sebasusnik/luz-galeria/exports/luz-galeria.netlist.txt

COMPONENTS:
 - J_IN: 
 - D1: D1, source_component
 - C_BULK: 220uF capacitor
 - J_OUT: 
 - ENC: 
 - RPU_A: 10kΩ resistor
 - RPU_B: 10kΩ resistor
 - RPU_SW: 10kΩ resistor
 - C_A: 10nF capacitor
 - C_B: 10nF capacitor
 - C_SW: 10nF capacitor
 - ESP: 
 - C_ESP: 100nF capacitor
 - J_RDR: 
 - C_RDR: 100nF capacitor
 - U_BUCK: 
 - R_LED: 1kΩ resistor
 - LED_PWR: LED_PWR, source_component
 - Q_WW: 
 - RG_WW: 100Ω resistor
 - RPD_WW: 10kΩ resistor
 - Q_CW: 
 - RG_CW: 100Ω resistor
 - RPD_CW: 10kΩ resistor

NET: D1_pos
  - J_IN V24
  - D1 pin1 (+)

NET: V3V3
  - ESP V3V3
  - RPU_SW pin2
  - RPU_B pin2
  - RPU_A pin2

NET: ENC_A
  - ESP IO4
  - C_A pin1 (+)
  - RPU_A pin1
  - ENC pin2

NET: ENC_B
  - ESP IO5
  - C_B pin1 (+)
  - RPU_B pin1
  - ENC pin3

NET: ENC_SW
  - ESP IO6
  - C_SW pin1 (+)
  - RPU_SW pin1
  - ENC pin4

NET: RDR_TX
  - J_RDR TX
  - ESP IO20

NET: RDR_RX
  - J_RDR RX
  - ESP IO21

NET: RDR_OUT
  - J_RDR OUT
  - ESP IO7

NET: V24
  - U_BUCK INp
  - J_OUT Vplus
  - C_BULK pin1 (+)
  - D1 pin2 (-)

NET: V5
  - R_LED pin1
  - U_BUCK OUTp
  - C_RDR pin1 (+)
  - J_RDR VCC
  - C_ESP pin1 (+)
  - ESP 5V

NET: LED_PWR_pos
  - R_LED pin2
  - LED_PWR pin1 (+)

NET: PWM_WW
  - RG_WW pin1
  - ESP IO10

NET: Q_WW_G
  - RPD_WW pin1
  - RG_WW pin2
  - Q_WW pin1

NET: WW
  - Q_WW pin2
  - J_OUT WW

NET: PWM_CW
  - RG_CW pin1
  - ESP IO3

NET: Q_CW_G
  - RPD_CW pin1
  - RG_CW pin2
  - Q_CW pin1

NET: GND
  - Q_CW pin3
  - RPD_CW pin2
  - Q_WW pin3
  - RPD_WW pin2
  - LED_PWR pin2 (-)
  - U_BUCK OUTn
  - U_BUCK INn
  - C_RDR pin2 (-)
  - J_RDR GND
  - C_ESP pin2 (-)
  - ESP GND
  - C_SW pin2 (-)
  - C_B pin2 (-)
  - C_A pin2 (-)
  - ENC pin7
  - ENC pin6
  - ENC pin5
  - ENC pin1
  - C_BULK pin2 (-)
  - J_IN GND

NET: CW
  - Q_CW pin2
  - J_OUT CW

COMPONENT_PINS:
J_IN
- pin1(V24): NETS(D1_pos)
- pin2(GND): NETS(GND)

D1
- pin1(pos, anode, left): NETS(D1_pos)
- pin2(neg, cathode, right): NETS(V24)

C_BULK (220uF undefined)
- pin1(pos): NETS(V24)
- pin2(neg): NETS(GND)

J_OUT
- pin1(Vplus): NETS(V24)
- pin2(WW): NETS(WW)
- pin3(CW): NETS(CW)

ENC
- pin1(C): NETS(GND)
- pin2(A): NETS(ENC_A)
- pin3(B): NETS(ENC_B)
- pin4(S1): NETS(ENC_SW)
- pin5(S2): NETS(GND)
- pin6(MP1): NETS(GND)
- pin7(MP2): NETS(GND)

RPU_A (10kΩ undefined)
- pin1(anode, pos, left): NETS(ENC_A)
- pin2(cathode, neg, right): NETS(V3V3)

RPU_B (10kΩ undefined)
- pin1(anode, pos, left): NETS(ENC_B)
- pin2(cathode, neg, right): NETS(V3V3)

RPU_SW (10kΩ undefined)
- pin1(anode, pos, left): NETS(ENC_SW)
- pin2(cathode, neg, right): NETS(V3V3)

C_A (10nF undefined)
- pin1(pos, left, anode): NETS(ENC_A)
- pin2(neg, right, cathode): NETS(GND)

C_B (10nF undefined)
- pin1(pos, left, anode): NETS(ENC_B)
- pin2(neg, right, cathode): NETS(GND)

C_SW (10nF undefined)
- pin1(pos, left, anode): NETS(ENC_SW)
- pin2(neg, right, cathode): NETS(GND)

ESP
- pin1(5V): NETS(V5)
- pin2(GND): NETS(GND)
- pin3(V3V3): NETS(V3V3)
- pin4(IO4): NETS(ENC_A)
- pin5(IO3): NETS(PWM_CW)
- pin6(IO2): NOT_CONNECTED
- pin7(IO1): NOT_CONNECTED
- pin8(IO0): NOT_CONNECTED
- pin9(IO5): NETS(ENC_B)
- pin10(IO6): NETS(ENC_SW)
- pin11(IO7): NETS(RDR_OUT)
- pin12(IO8): NOT_CONNECTED
- pin13(IO9): NOT_CONNECTED
- pin14(IO10): NETS(PWM_WW)
- pin15(IO20): NETS(RDR_TX)
- pin16(IO21): NETS(RDR_RX)

C_ESP (100nF undefined)
- pin1(pos, left, anode): NETS(V5)
- pin2(neg, right, cathode): NETS(GND)

J_RDR
- pin1(VCC): NETS(V5)
- pin2(GND): NETS(GND)
- pin3(TX): NETS(RDR_TX)
- pin4(RX): NETS(RDR_RX)
- pin5(OUT): NETS(RDR_OUT)

C_RDR (100nF undefined)
- pin1(pos, left, anode): NETS(V5)
- pin2(neg, right, cathode): NETS(GND)

U_BUCK
- pin1(INp): NETS(V24)
- pin2(INn): NETS(GND)
- pin3(OUTp): NETS(V5)
- pin4(OUTn): NETS(GND)

R_LED (1kΩ undefined)
- pin1(anode, pos, left): NETS(V5)
- pin2(cathode, neg, right): NETS(LED_PWR_pos)

LED_PWR
- pin1(anode, pos, left): NETS(LED_PWR_pos)
- pin2(cathode, neg, right): NETS(GND)

Q_WW
- pin1(G): NETS(Q_WW_G)
- pin2(D): NETS(WW)
- pin3(S): NETS(GND)

RG_WW (100Ω undefined)
- pin1(anode, pos, left): NETS(PWM_WW)
- pin2(cathode, neg, right): NETS(Q_WW_G)

RPD_WW (10kΩ undefined)
- pin1(anode, pos, left): NETS(Q_WW_G)
- pin2(cathode, neg, right): NETS(GND)

Q_CW
- pin1(G): NETS(Q_CW_G)
- pin2(D): NETS(CW)
- pin3(S): NETS(GND)

RG_CW (100Ω undefined)
- pin1(anode, pos, left): NETS(PWM_CW)
- pin2(cathode, neg, right): NETS(Q_CW_G)

RPD_CW (10kΩ undefined)
- pin1(anode, pos, left): NETS(Q_CW_G)
- pin2(cathode, neg, right): NETS(GND)
