sebasusnik/luz-galeria/exports/luz-galeria.kicad_sch

## KiCad design exports/luz-galeria.kicad_sch (2026-05-30)

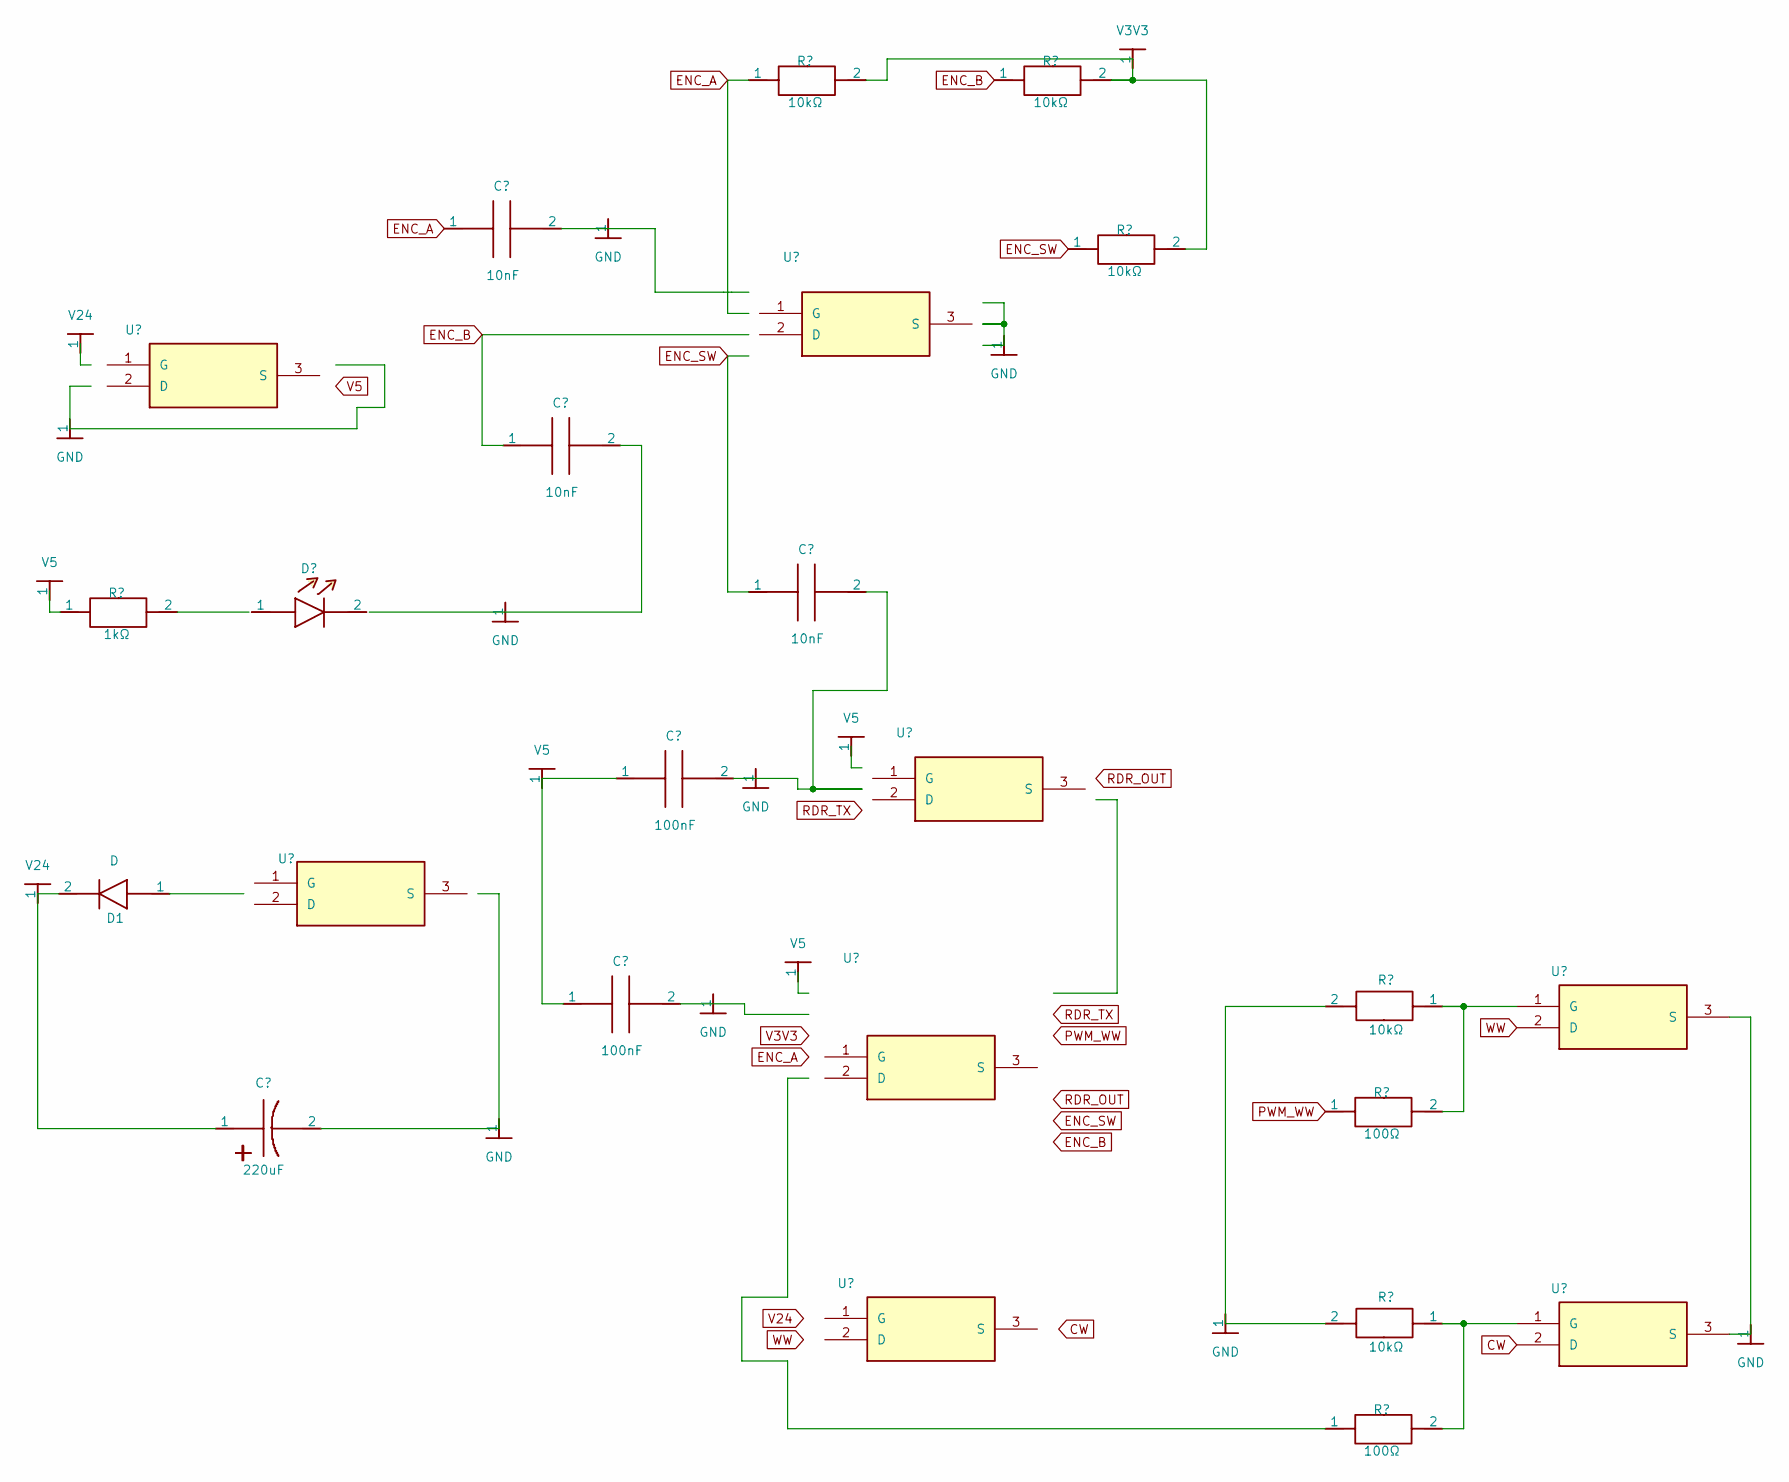
[picture p1: schematic luz-galeria.kicad_sch]

Parts:
D1: D
GND: GND
V3V3: V3V3
V5: V5
V24: V24
