sebasusnik/luz-galeria/(commit log)

2026-05-28 Initial commit: LUZ-GALERIA CCT LED controller
    tscircuit design for a 24V CCT LED-strip controller (ESP32-C3 + LD2410C
    radar + EC11 encoder, dual low-side PWM MOSFET driver, MP1584 buck).
    - index.circuit.tsx + lib/: functional components (PowerInput, BuckRegulator,
    Microcontroller, MosfetDriver, OutputTerminal, EncoderInput, RadarConnector),
    board with design rules, GND pour, mounting holes, cadModel volumes.
    - scripts/stripboard_layout.mjs: v0 DIY stripboard layout generator with
    electrical verifier (auto cuts/jumpers, short/open check) + SVG render.
    - PROMPT.md: original project spec.
    Netlist builds clean (connectivity validated). v0 = THT DIY rig to validate
    firmware/behavior; v1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
2026-05-28 Add KiCad/VeroRoute export + Windows build guide
    - docs/KICAD-VEROROUTE.md: step-by-step to lay out the v0 stripboard from
    Windows using VeroRoute (install, netlist import/manual, custom module
    footprints, autoroute, orientation/pinout notes).
    - exports/: KiCad schematic, complete readable netlist (18 nets), and the
    verified stripboard plan SVG.
    [luz-galeria.kicad_sch]
2026-05-30 Fix EC11 encoder left unconnected by empty KiCad footprint
    The kicad: footprint for the Alps EC11E resolved to zero pads in this
    tscircuit version, so all seven encoder traces were silently dropped and
    the encoder had no electrical connection in the netlist.
    Replace it with a self-contained Ec11Footprint (geometry transcribed from
    the official KiCad library: C/A/B/S1/S2 signal pads + two 2.5mm mounting
    posts) with named ports, and wire MP1/MP2 to GND. Also add React keys to
    the ESP32 footprint hole list to clear the render warning.
    https://claude.ai/code/session_01ShC9W1aj1k3gaTpsgCGkmU
    [luz-galeria.kicad_sch]
2026-05-30 Add ESPHome firmware + fabrication guide
    - firmware/luz-galeria.yaml: CWWW dual-PWM light, LD2410 radar presence,
    EC11 encoder (rotate=brightness, press+rotate=color temp, click=toggle),
    presence auto-mode with timeout. Pinout matches the PCB netlist.
    - firmware/secrets.yaml.example: template for wifi/api/ota credentials.
    - docs/FABRICACION.md: step-by-step guide to fab the board (verification
    checklist, gerber/BOM export, JLCPCB vs PCB Ingenieria, BOM table).
    - .gitignore: never commit ESPHome secrets.
    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
2026-05-30 Convert discretes to through-hole (THT) for local sourcing + hand soldering
    All SMD discretes replaced with leaded parts so they can be bought in
    Buenos Aires and soldered by hand (no SMD, no waiting on China):
    - MOSFETs: AO3400 SOT-23 -> IRLZ44N TO-220. CRITICAL: the TO-220 pinout is
    G-D-S (pin1=Gate, pin2=Drain, pin3=Source), DIFFERENT from the SOT-23
    G-S-D. New To220Footprint has named G/D/S pads; verified in the netlist
    that Drain->strip (WW/CW) and Source->GND.
    - Diode: SS34/SS54 SMA -> 1N5822 axial (AxialDiodeFootprint).
    - Resistors: 0805 -> axial 1/4W (AxialResistorFootprint).
    - Ceramic caps: 0805 -> leaded (CeramicCapFootprint).
    - LED: 0805 -> 3mm THT (ThtLedFootprint).
    Re-laid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
    [luz-galeria.kicad_sch]
2026-05-30 Re-layout: I/O on short edges, encoder flipped, full KiCad project export
    Placement changes (App.tsx):
    - Both terminals (J_IN/J_OUT) stacked on the LEFT short edge with screw
    openings facing -X (cables exit the same narrow side). Required rotating
    each terminal chip 270deg and relocating D1/C_BULK to the +X interior
    side of PowerInput.
    - Encoder moved to the RIGHT short edge alone, so the knob is accessible
    without obstruction from the other components. Encoder support passives
    (RPU/C) moved to the -X interior side of EncoderInput.
    - MosfetDriver shifted up; BuckRegulator nudged + its LED row tucked just
    below the MP1584 body to clear C_ESP (left) and the encoder pull-ups
    (righ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
    [luz-galeria.kicad_pcb, luz-galeria.kicad_sch]
